richardhemphill/ECE5595/README.md

# ECE5595
Source code for ECE5595 projects.
