richardhemphill/ECE5595/canChat/README.md

Source code for Arduino implementation of CAN Chat.
