richardhemphill/ECE5595/(list of files, drawings)

Other design files:
canChat/mega/mega.fzz
canChat/uno/uno.fzz
